yann-schyrol/Double-Side-Exposure-Unite/IMG_20210807_233134_8.jpg

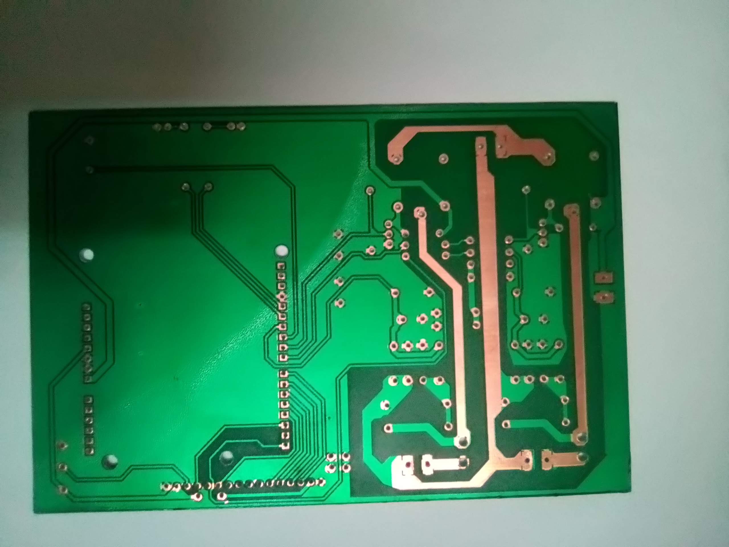
IMG_20210807_233134_8.jpg
