yann-schyrol/Double-Side-Exposure-Unite/IMG_20210807_204930_6.jpg

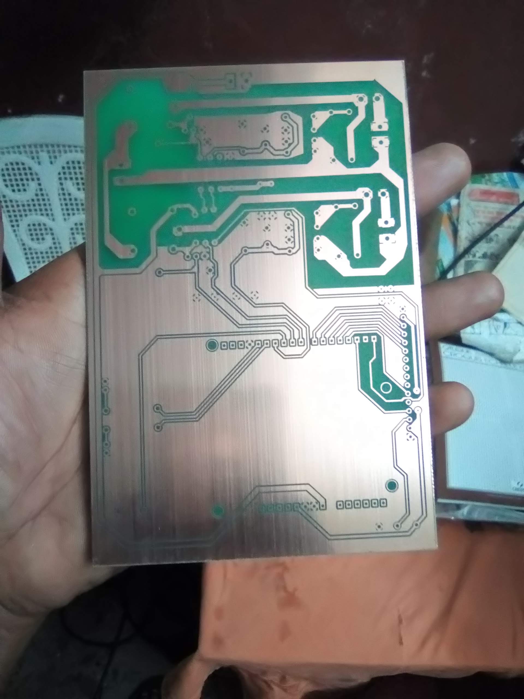
IMG_20210807_204930_6.jpg
