yann-schyrol/Double-Side-Exposure-Unite/README.md

# PCB Exposure Unit Circuit Design

Welcome to the Circuit Design Bootcamp/Training project! 
This repository contains all the necessary files and documentation
to help you design and build a Double-Sided Exposure Unit.
This project is aimed at beginners and intermediate enthusiasts 
who are interested in learning more about circuit design, PCB layout, and fabrication.
 
Repository Structure
  ---------------
 
-Design Files: Contains all design-related files for the exposure unit.
-
-Simulation Files: Includes the Proteus simulation file and the Arduino code in HEX format.
-
-PCB Files: Contains the PCB Gerber files and the BOM required for PCB manufacturing.
-
