yann-schyrol/Double-Side-Exposure-Unite/PCB_Layout_Planning.pdf

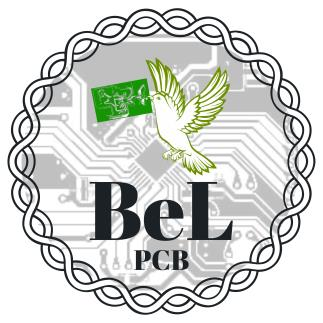
[picture p5: figure]

PCB Layout Planning

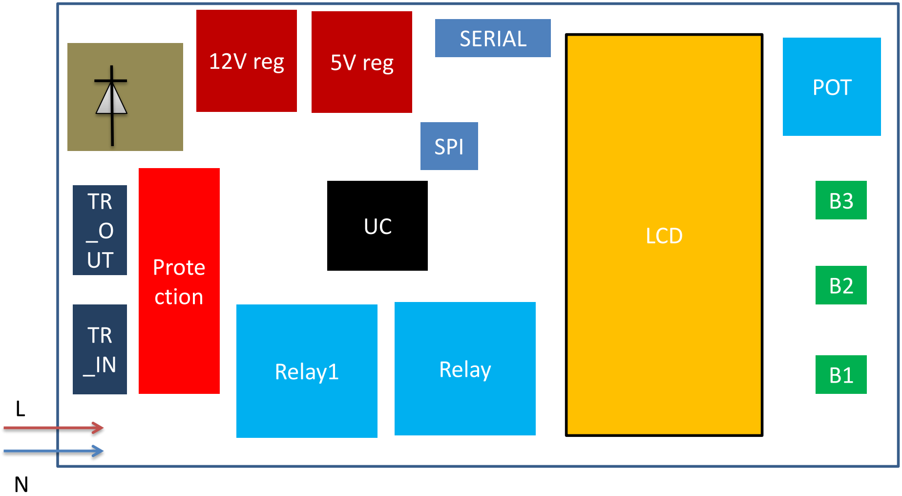
[picture p6: figure]
LCD; POT; 12V reg; 5V reg; SPI; SERIAL; Prote ction; Relay1; Relay
