yann-schyrol/Double-Side-Exposure-Unite/IMG-20200707-WA0022.jpg

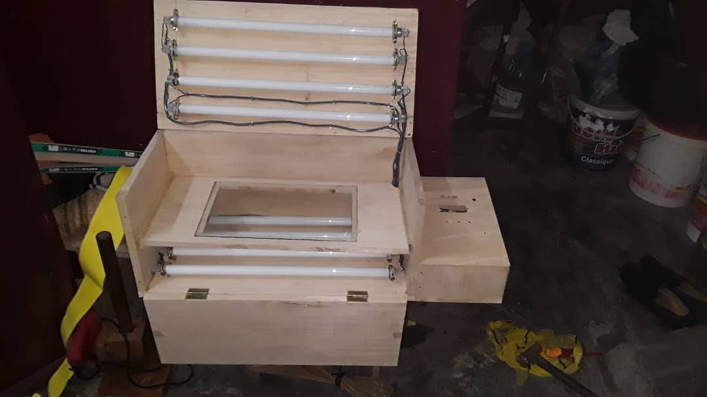
IMG-20200707-WA0022.jpg
