yann-schyrol/Double-Side-Exposure-Unite/IMG_20201024_001136_8.jpg

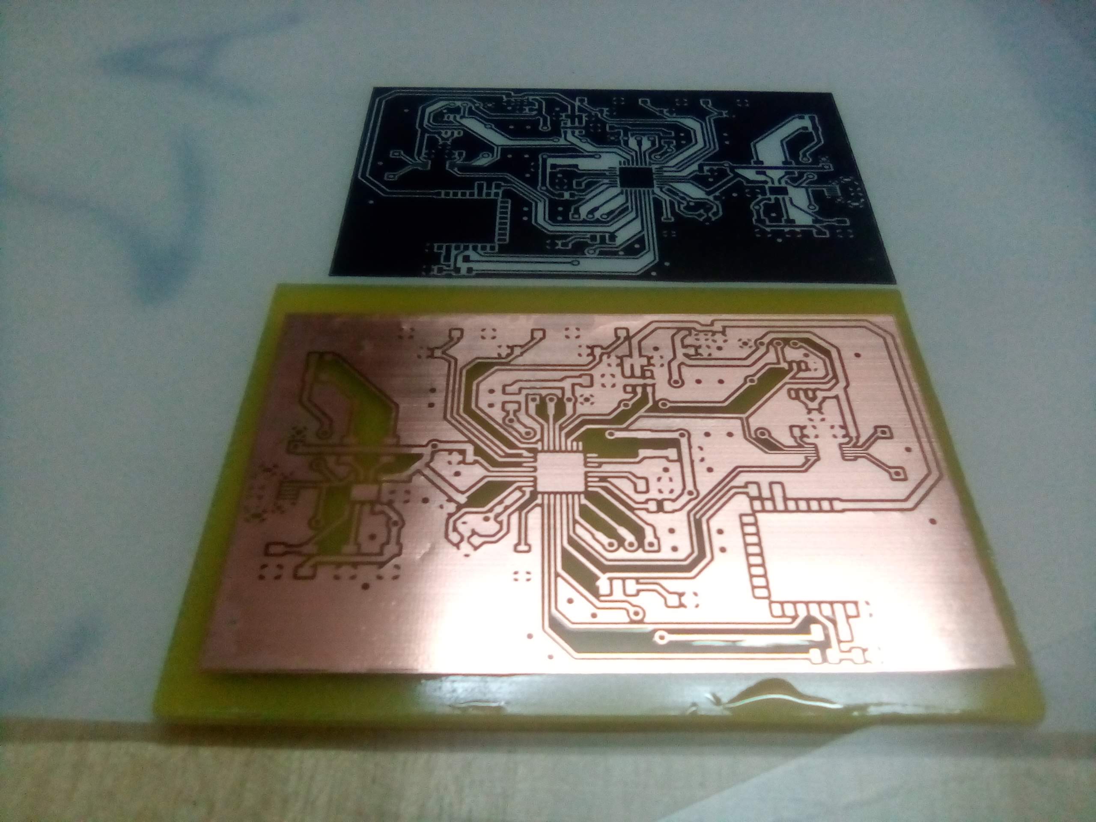
IMG_20201024_001136_8.jpg
