yann-schyrol/Double-Side-Exposure-Unite/PCB Fabriation Files/BOM_BeL-PCB's-EXposure-Unit_2024-05-17.csv

ID | Name | Designator | Footprint | Quantity | Manufacturer Part | Manufacturer | Supplier | Supplier Part | Price
1 | 100nF | C3,C5,C7,C8,C11 | RAD-0.2 | 5 | 0.1UF(104) +-20% 63v | LCSC | LCSC | C19355 | 0.011
2 | 330nF | C4,C6,C15 | RAD-0.2 | 3 | 0.1UF(104) +-20% 63v | LCSC | LCSC | C19355 | 0.011
3 | 1uF | C9,C10 | RAD-0.2 | 2 | 0.1UF(104) +-20% 63v | LCSC | LCSC | C19355 | 0.011
4 | YS-MBZ12085C03R16 | BUZZER | BUZ-TH_BD12.0-P6.50-D0.6-FD | 1 | YS-MBZ12085C03R16 | Fengming | LCSC | C409843 | 0.116
5 | 1000uF | C1,C2 | CAP-TH_BD10.0-P5.00-D1.0-FD | 2 | 1000uF 25V Green high frequency | ValuePro | LCSC | C43353 | 0.092
6 | 22pF | C12,C13 | CAP-TH_L3.5-W3.0-P2.54-D0.8 | 2 | 22pf/50V 10% | ReliaPro | LCSC | C9316
7 | 1N4007 | D1,D2,D3,D4 | DO-41_BD2.4-L4.7-P8.70-D0.9-RD | 4 | 1N4007 | SEMTECH | LCSC | C106903 | 0.016
8 | 1N4148 | D5,D6 | DIODE-1N4148 | 2
9 | 1.5A 250VAC | F1 | FUSE-TH_BD4.0-L11.0-P15.00-D0.6 | 1 | 10A 250VAC | XCFuse | LCSC | C29778 | 0.065
10 | 散热片15.5*10.5*24 带针 | HS1,HS2 | HEATSINK-TH_L15.5-W10.5-XSD1226-005 | 2 | 散热片15.5*10.5*24 带针 | XSD(鑫顺达) | LCSC | C108928 | 0.056
11 | 3MMHOLE_PTH | L,N | 3MMHOLE_PTH | 2
12 | 1ouH | L1 | L_AXIAL-0.4 | 1
13 | 2N7000-D26Z | Q1,Q2 | TO-92-3_L4.8-W3.7-P2.54-L | 2 | 2N7000-D26Z | ON Semicon | LCSC | C258193 | 0.241
14 | 1k | R1,R3,R5,R6,R7,R8,R9,R12 | R_AXIAL-0.4 | 8
15 | 10k | R4,R10 | R_AXIAL-0.4 | 2
16 | VDR | R2 | RES-TH_L28.0-W5.4-P12.50-D1.1-S5.40 | 1 | VDR-25D271K | VDR Varistor | LCSC | C273578 | 0.63
17 | 100kΩ | R11 | RES-ADJ-TH_RK1631110U1Q | 1 | RK1631110U1Q | ALPS Electric | LCSC | C370978 | 2.096
18 | SRD-12VDC-SL-C | RL1,RL2 | RELAY-TH_SRD-XXVDC-XL-C | 2 | SRD-12VDC-SL-C | SONGLE | LCSC | C30431 | 0.311
19 | 31001102 | TR_IN,TR_OUT,RL1_OUT,RL2_OUT | CONN-TH_2P-P5.08_31001102 | 4 | 31001102 | METZ CONNECT | LCSC | C123210
20 | 7805 | U2 | TO-220-3_L10.0-W4.5-P2.54-L | 1 | L7805CV-DG | STMicroelectronics | LCSC | C3795 | 0.182
21 | 7812 | U4 | TO-220-3_L10.0-W4.5-P2.54-L | 1 | MC7812BTG | ON | LCSC | C45387 | 0.461
22 | PC817 | U3,U5 | DIP-4_L6.4-W4.6-P2.54-LS7.6-BL | 2 | PC817X2NSZ9F(B) | SHARP | LCSC | C60965 | 0.08
23 | 16MHz | X1 | HC-49US_L11.5-W4.5-P4.88 | 1 | XIHCELNANF-16MHZ | TAITIEN Elec | LCSC | C295075 | 0.092
24 | 10uF | C14 | CAP-TH_BD5.0-P2.00-D0.8-FD | 1 | 10uF 25V 5*11 | ValuePro | LCSC | C43347 | 0.012
25 | K4-6×6_TH | RST,B1,B2,B3 | KEY-TH_4P-L6.0-W6.0-P4.50-LS6.5 | 4 | K2-1102DP-E4SW-04 | 韩国韩荣 | LCSC | C136684 | 0.038
26 | HDR-M-2.54_1x4 | USART | HDR-M-2.54_1X4 | 1 |  |  | LCSC | C124378 | 0.04
27 | ATMEGA328P-AU | U1 | TQFP-32_L7.0-W7.0-P0.80-LS9.0-BL | 1 | ATMEGA328P-AU | MICROCHIP | LCSC | C14877 | 2.121
28 | HDR-M-2.54_2x3 | ICSP | HDR-M-2.54_2X3 | 1 |  |  | LCSC | C65114 | 0.029
29 | LCD-1602-I2C-v2 | LCD | LCD-1602-I2C-V2 | 1
30 | LED-TH-5mm_G | L_RL1,L_RL2 | LED-TH_BD5.0_GREEN | 2 | 333-2SYGD/S530-E2 | EVERLIGHT(台湾亿光) | LCSC | C88163 | 0.031
