yann-schyrol/Double-Side-Exposure-Unite/Schematic_BeL PCB's EXposure Unit_2022-06-10.pdf

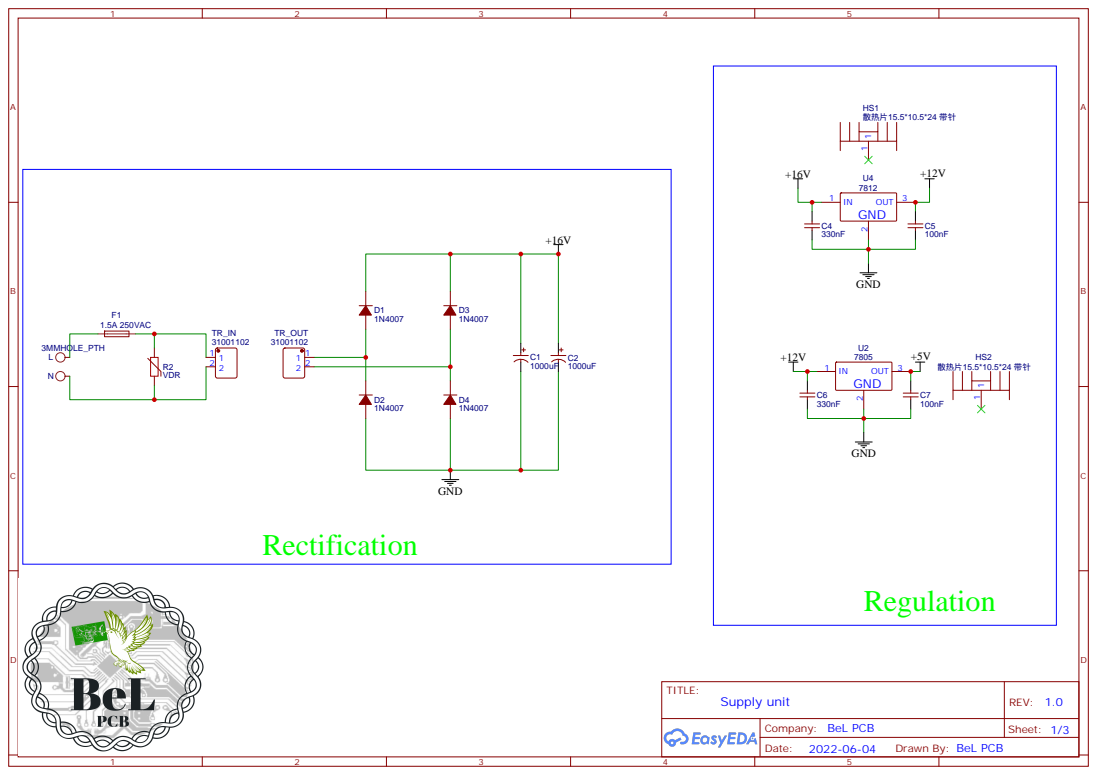
[picture p9: page 1]

Drawn By: BeL PCB

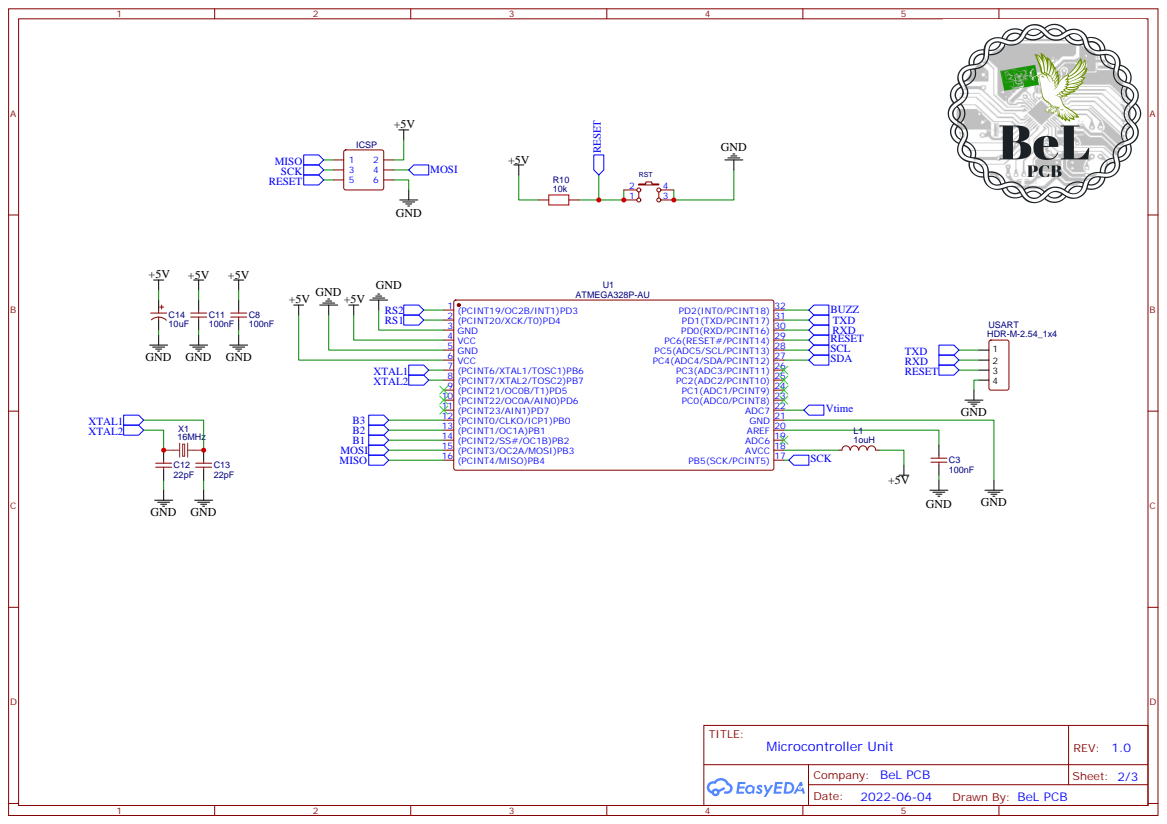
[picture p10: page 2]

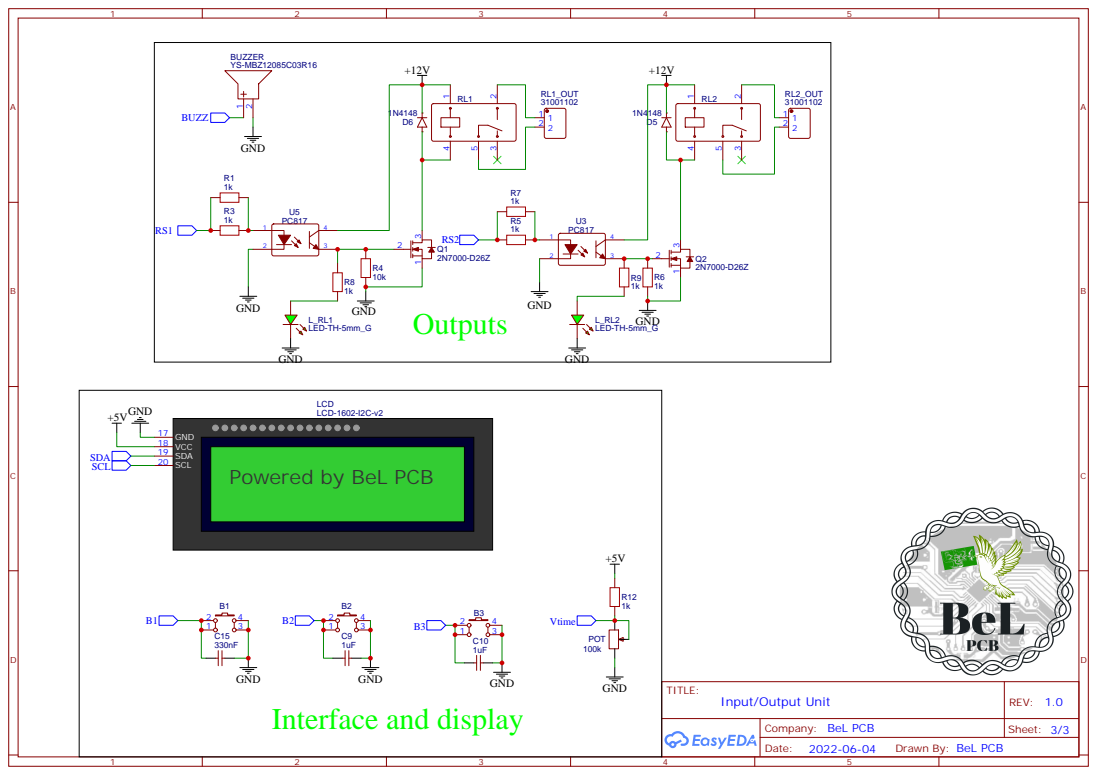
[picture p11: page 3]
