yann-schyrol/Double-Side-Exposure-Unite/BlockDiagram_EposureUnit.pdf

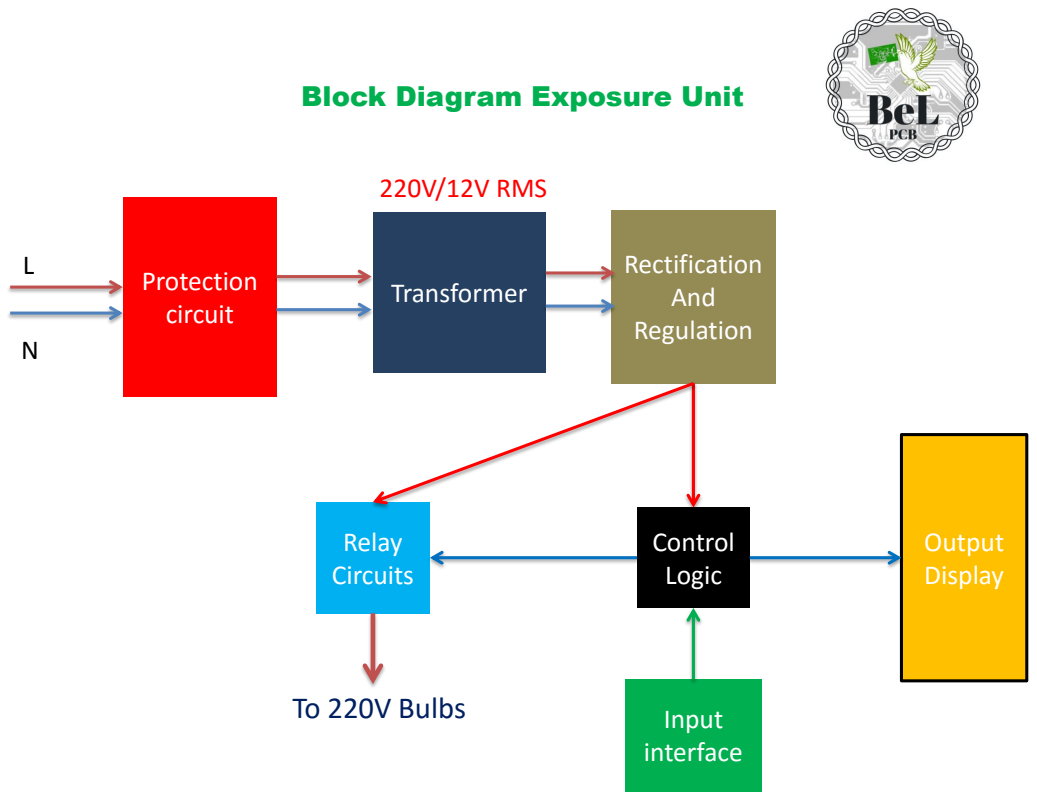
[picture p12: page 1]
Output Display; Input interface; Rectification And Regulation; Control Logic; Protection circuit; Relay Circuits; Transformer; 220V/12V RMS; To 220V Bulbs

Block Diagram Exposure Unit
