yann-schyrol/Double-Side-Exposure-Unite/(list of files, drawings)

Other design files:
Simulation Files/BeLPCB_ExposureUnitBoard.pdsprj
